enoch-chang/Flashing-Lights-Project/Photos/inside.jpg

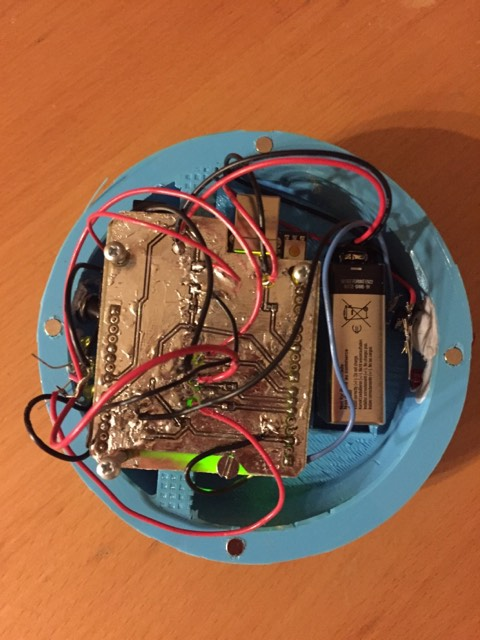
Photos/inside.jpg
