enoch-chang/Flashing-Lights-Project/Photos/three-pieces.jpg

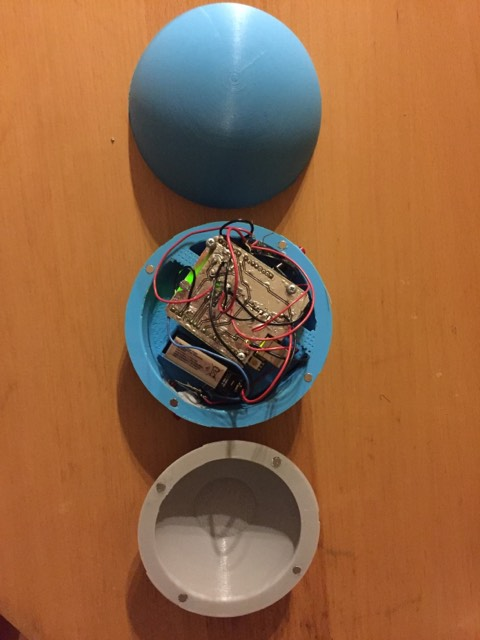
Photos/three-pieces.jpg
