enoch-chang/Flashing-Lights-Project/README.md

# Flashing-Lights-Project

Lights will be flashing.

Demo: https://youtu.be/DI44GL3oFzs
