enoch-chang/Flashing-Lights-Project/Electronics/Circuit-Sketch.pdf

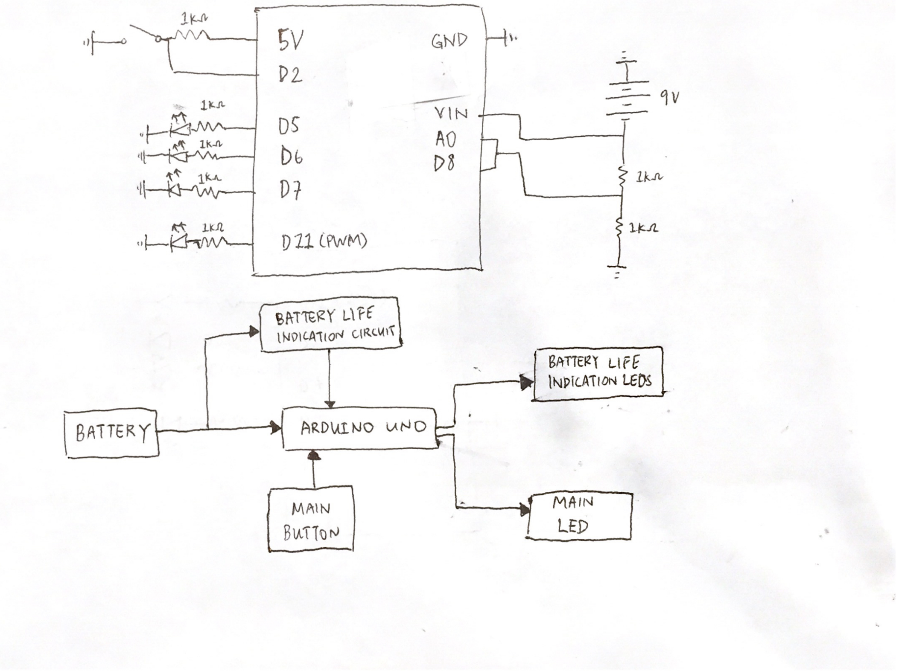
[picture p3: page 1]
