enoch-chang/Flashing-Lights-Project/Software/Software-Flowchart.pdf

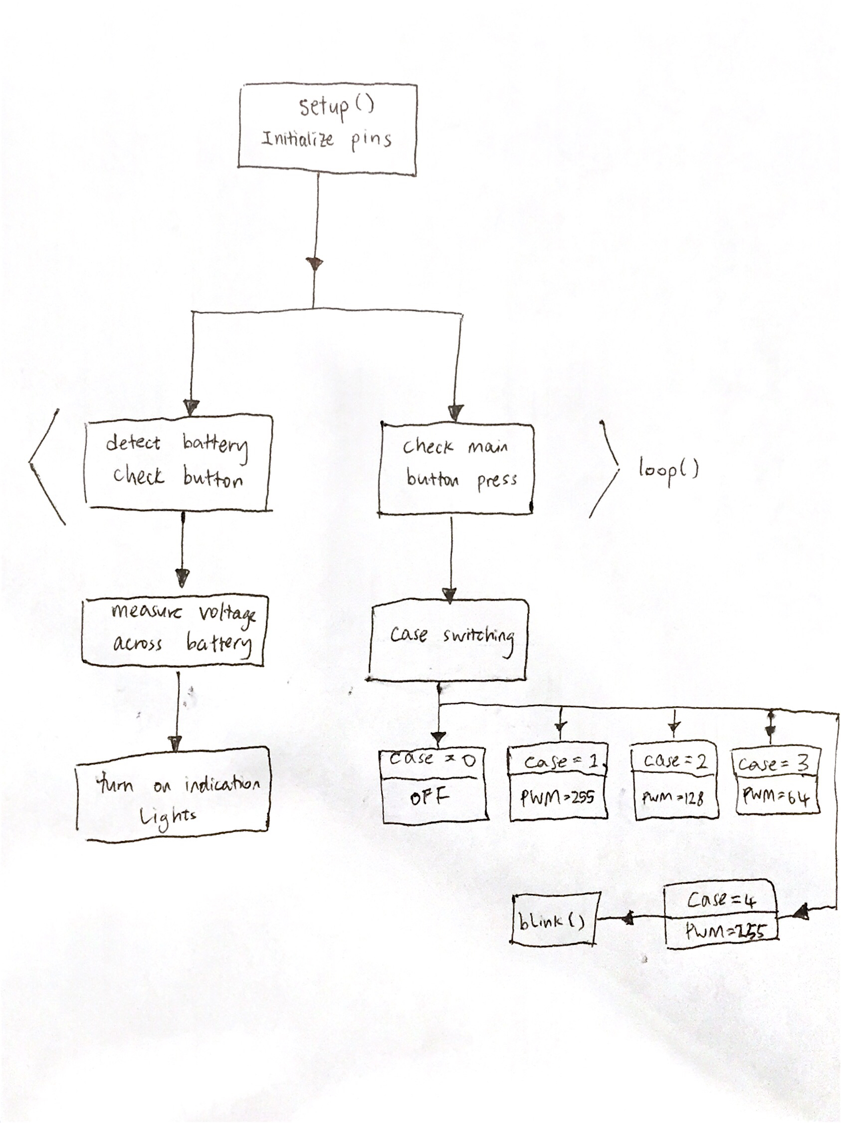
[picture p4: page 1]
