enoch-chang/Flashing-Lights-Project/Photos/back.jpg

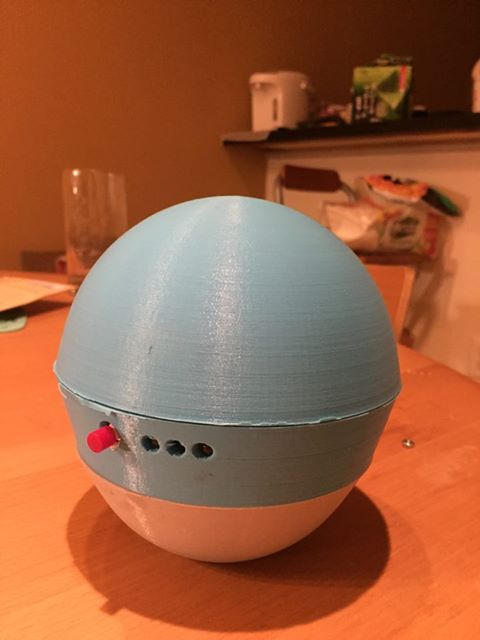
Photos/back.jpg
