enoch-chang/Flashing-Lights-Project/Photos/front.jpg

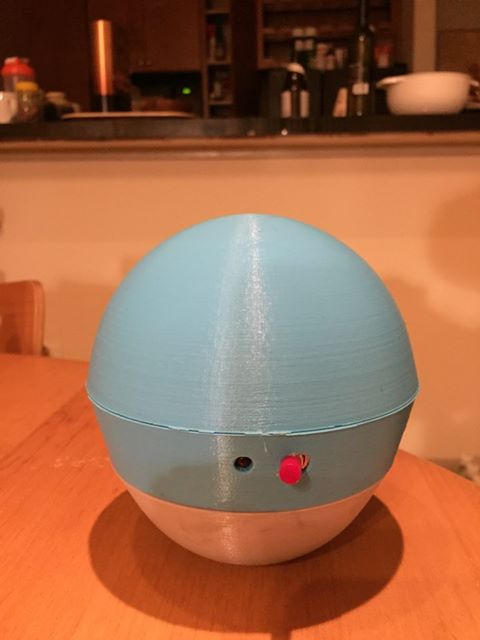
Photos/front.jpg
