enoch-chang/Flashing-Lights-Project/Mechanical/STL Files for Printing/hemisphere-middle.stl

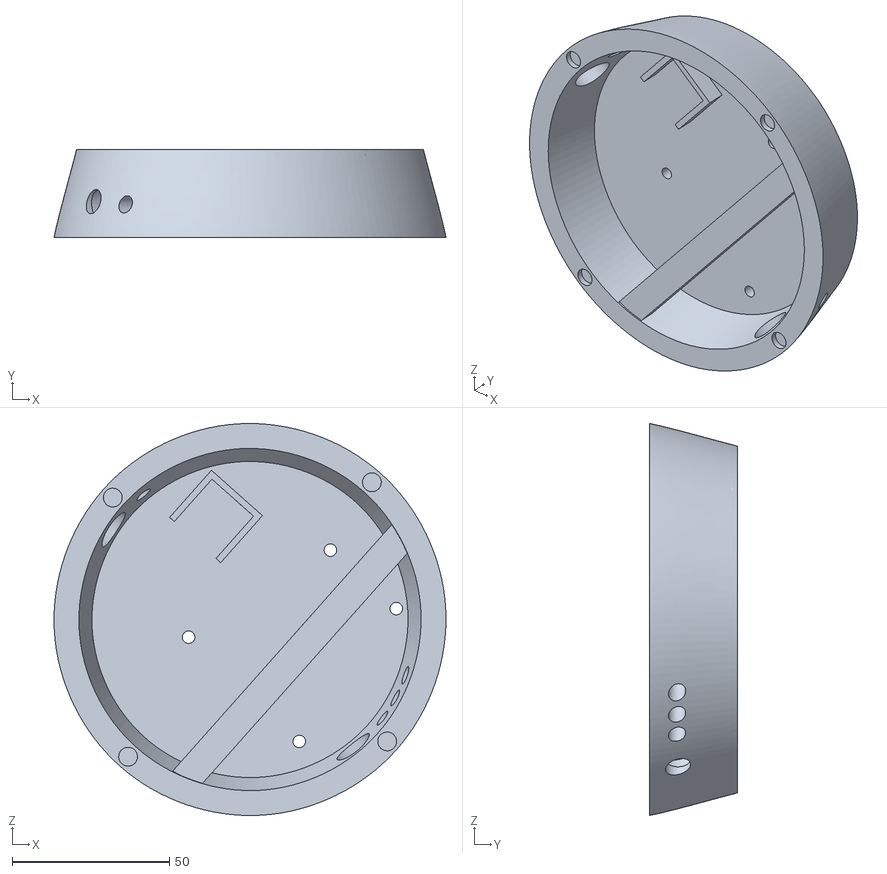
[picture p7: CAD file, 2018-12-14]
Mechanical/STL Files for Printing/hemisphere-middle.stl
124.6 x 28.0 x 124.6
