enoch-chang/Flashing-Lights-Project/Mechanical/STL Files for Printing/hemisphere-bottom.stl

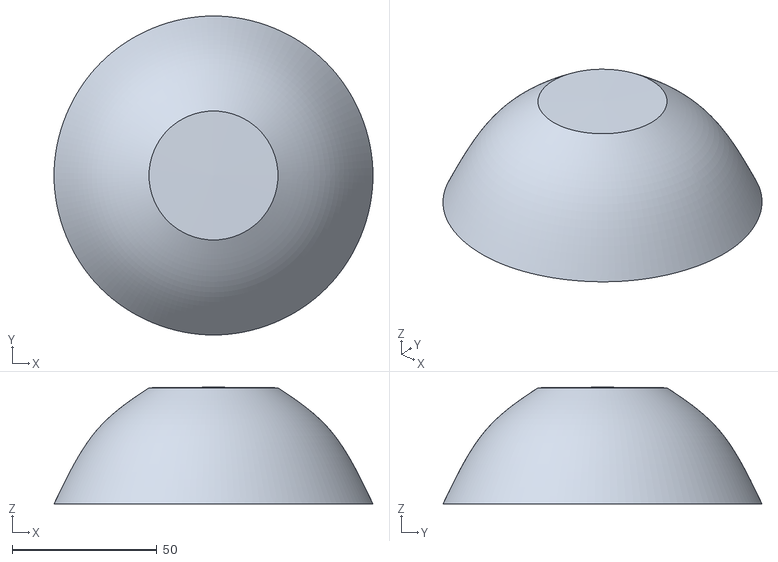
[picture p8: CAD file, 2018-12-14]
Mechanical/STL Files for Printing/hemisphere-bottom.stl
110.3 x 110.3 x 40.4
