enoch-chang/Flashing-Lights-Project/(list of files, cad)

Other CAD files:
Mechanical/Light Project 3 Piece v15.f3d
Mechanical/Light-Case-Model.f3d
