enoch-chang/Flashing-Lights-Project/Mechanical/CAD-Drawing-v1.pdf

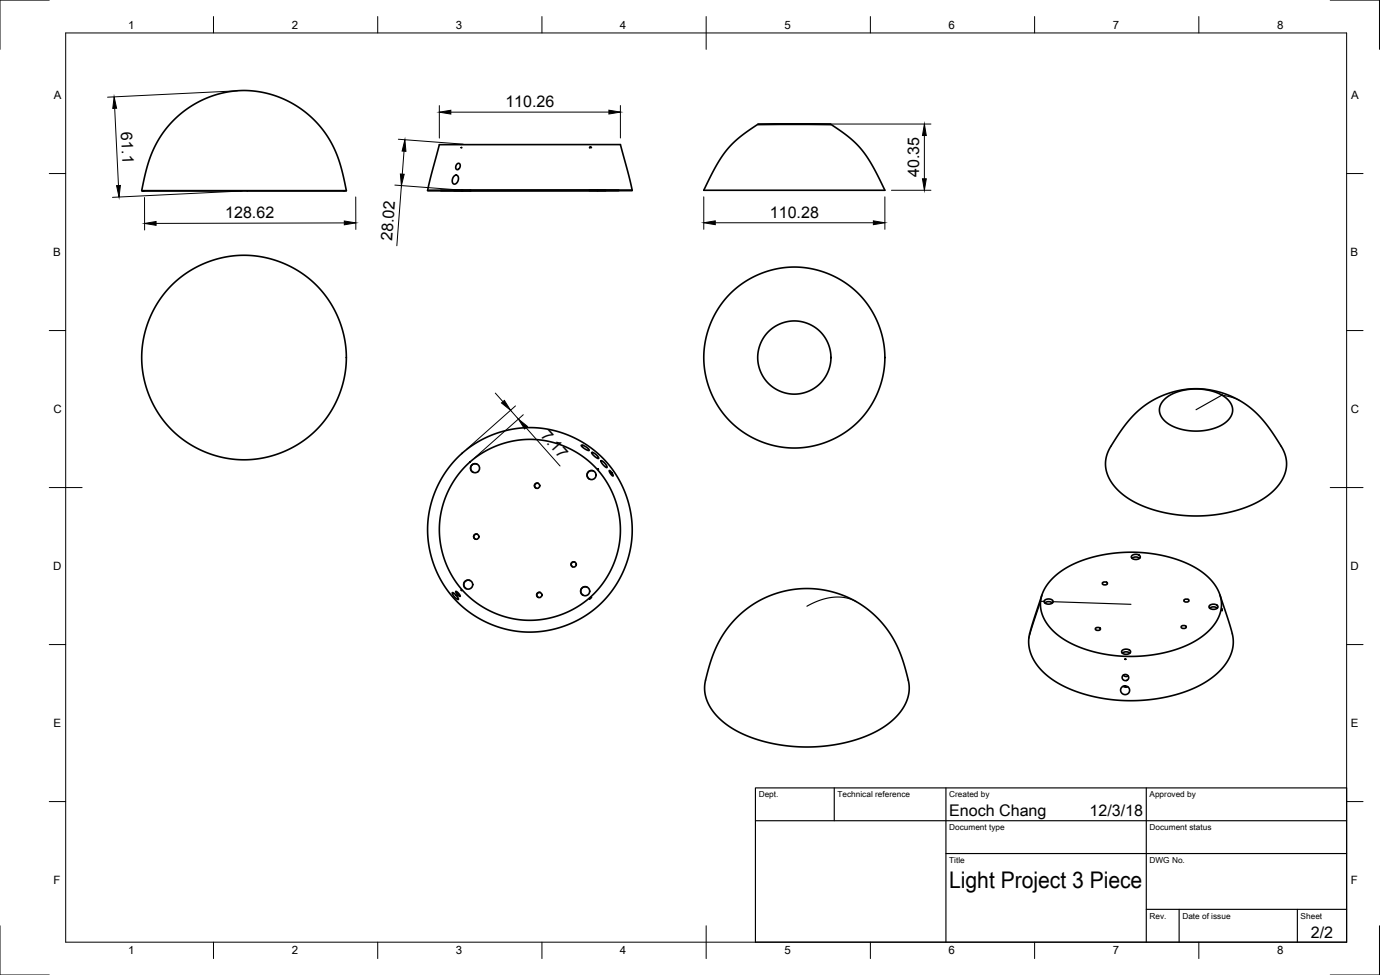
[picture p9: page 1]

Dept. | Technical reference | Created by Enoch Chang 12/3/18 | Approved by

Document type | Document status

Title Light Project 3 Piece | DWG No.

Rev. | Date of issue | Sheet 2/2
