enoch-chang/Flashing-Lights-Project/Electronics/Circuit-PCB.pdf

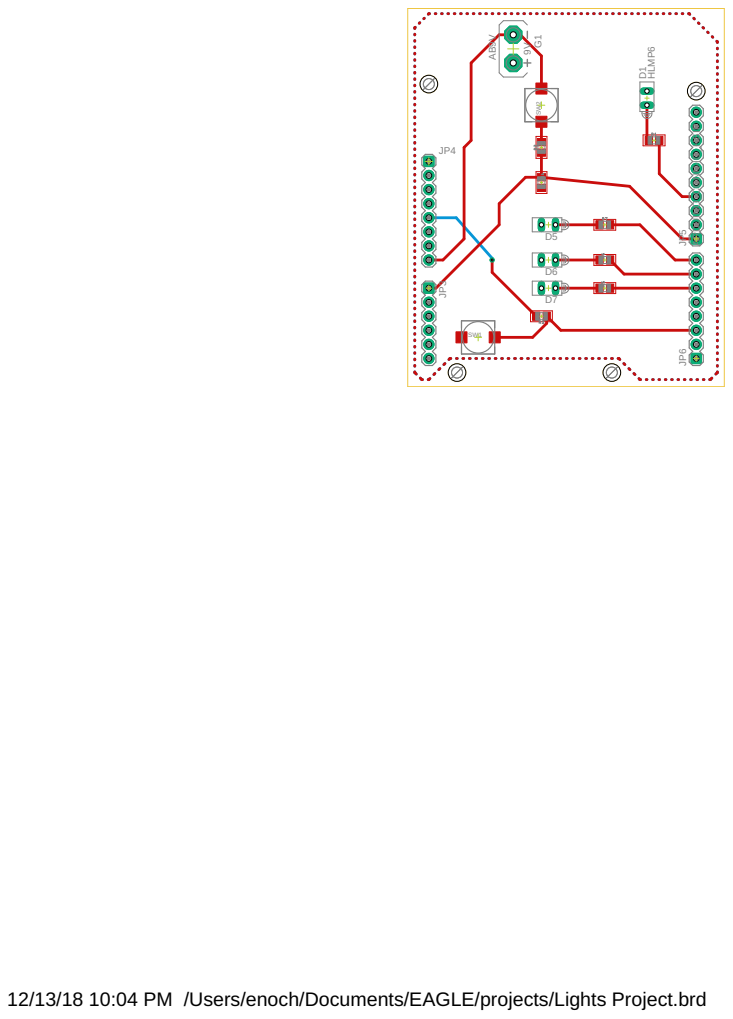
[picture p10: page 1]

12/13/18 10:04 PM /Users/enoch/Documents/EAGLE/projects/Lights Project.brd
