enoch-chang/Flashing-Lights-Project/Electronics/Circuit-Schematic.pdf

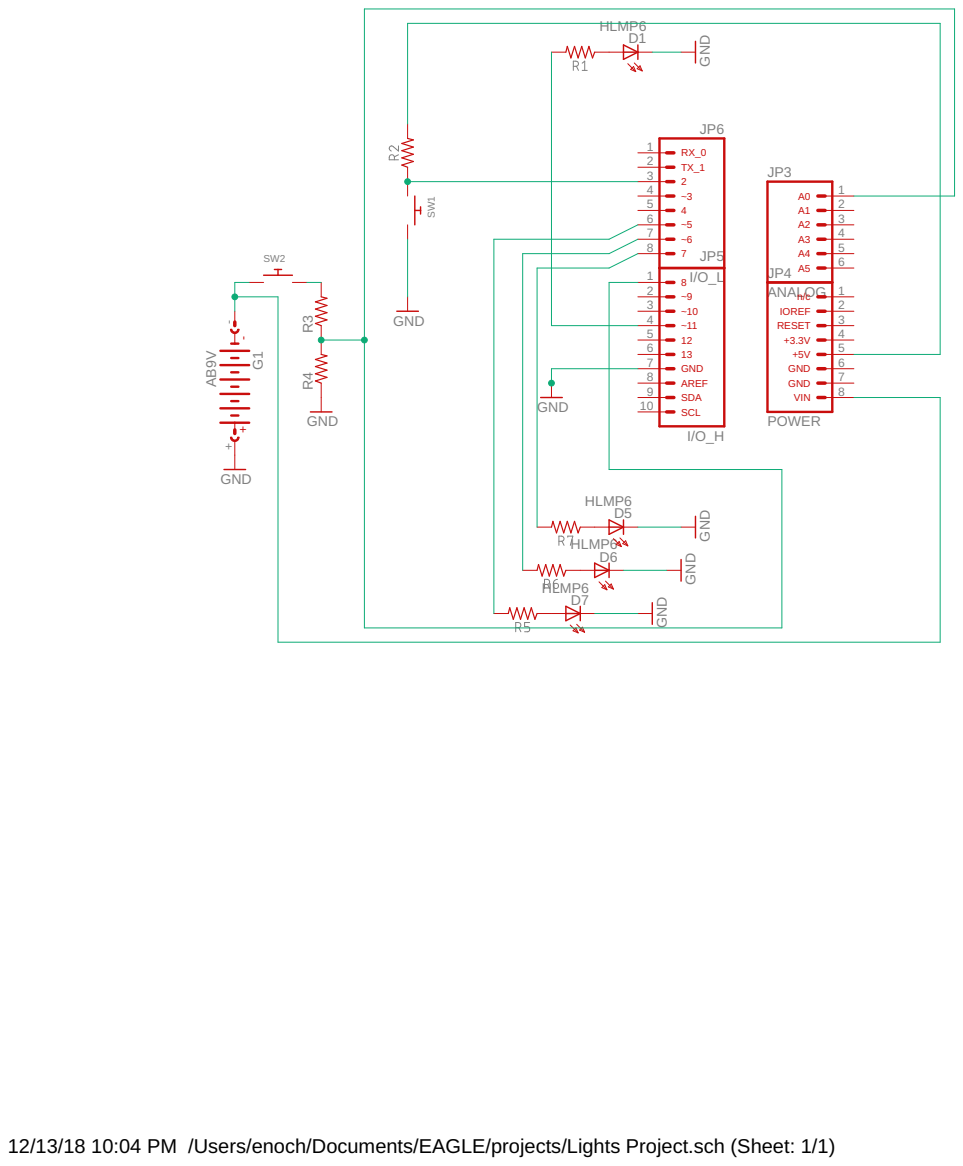
[picture p11: page 1]

12/13/18 10:04 PM /Users/enoch/Documents/EAGLE/projects/Lights Project.sch (Sheet: 1/1)
