enoch-chang/Flashing-Lights-Project/Electronics/Lights Project PCB.pdf

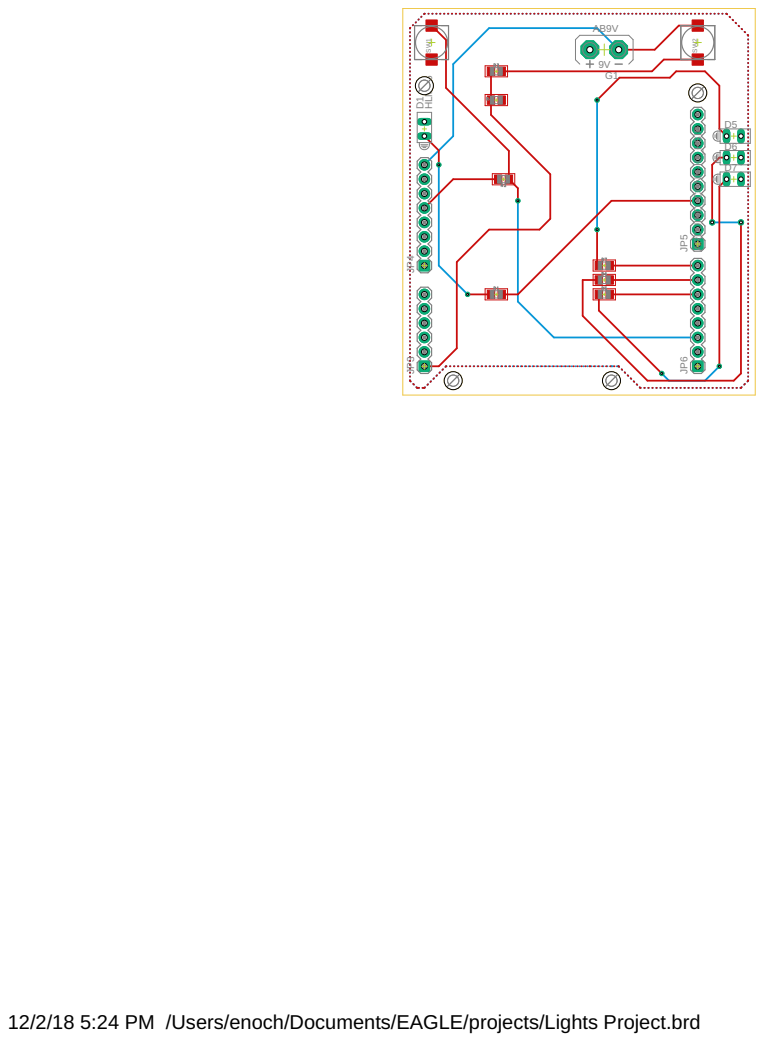
[picture p12: page 1]

12/2/18 5:24 PM /Users/enoch/Documents/EAGLE/projects/Lights Project.brd
