enoch-chang/Flashing-Lights-Project/Electronics/Lights Project.brd

## EAGLE design Electronics/Lights Project.brd (2018-11-21)

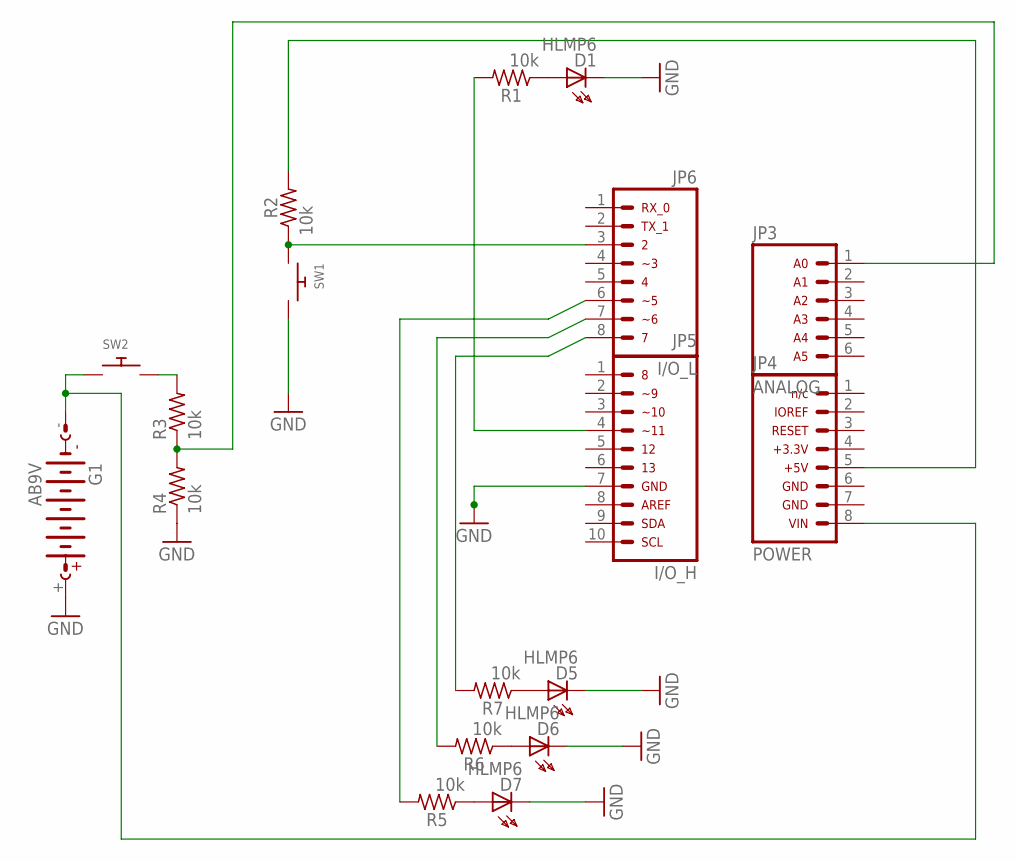
[picture p13: schematic Lights Project.sch]

Parts:
D1, D5, D6, D7: HLMP6
G1: AB9V
JP3: ARDUINO_CONN-ANALOGSIP; CONN-1X06
JP4: ARDUINO_CONN-POWERSIP; CONN-1X08
JP5: ARDUINO_CONN-IO_HSIP; CONN-1X10
JP6: ARDUINO_CONN-IO_LSIP; CONN-1X08
R1, R2, R3, R4, R5, R6, R7: 10k; R0805
SW1, SW2: SWITCH_PUSHBUTTONSOFTTOUCHSMD_SJ; PUSHBUTTON_SMD_SJ

Connections:
GND: D1.K, D5.K, D6.K, D7.K, G1.+, JP5.7, R4.1, SW1.P$2
unnamed: G1.-, JP4.8, SW2.P$1
unnamed: JP5.4, R1.2
unnamed: D1.A, R1.1
unnamed: D5.A, R7.1
unnamed: JP6.3, R2.1, SW1.P$1
unnamed: R3.2, SW2.P$2
unnamed: D6.A, R6.1
unnamed: JP6.6, R5.2
unnamed: D7.A, R5.1
unnamed: JP6.7, R6.2
unnamed: JP6.8, R7.2
unnamed: JP3.1, R3.1, R4.2
unnamed: JP4.5, R2.2

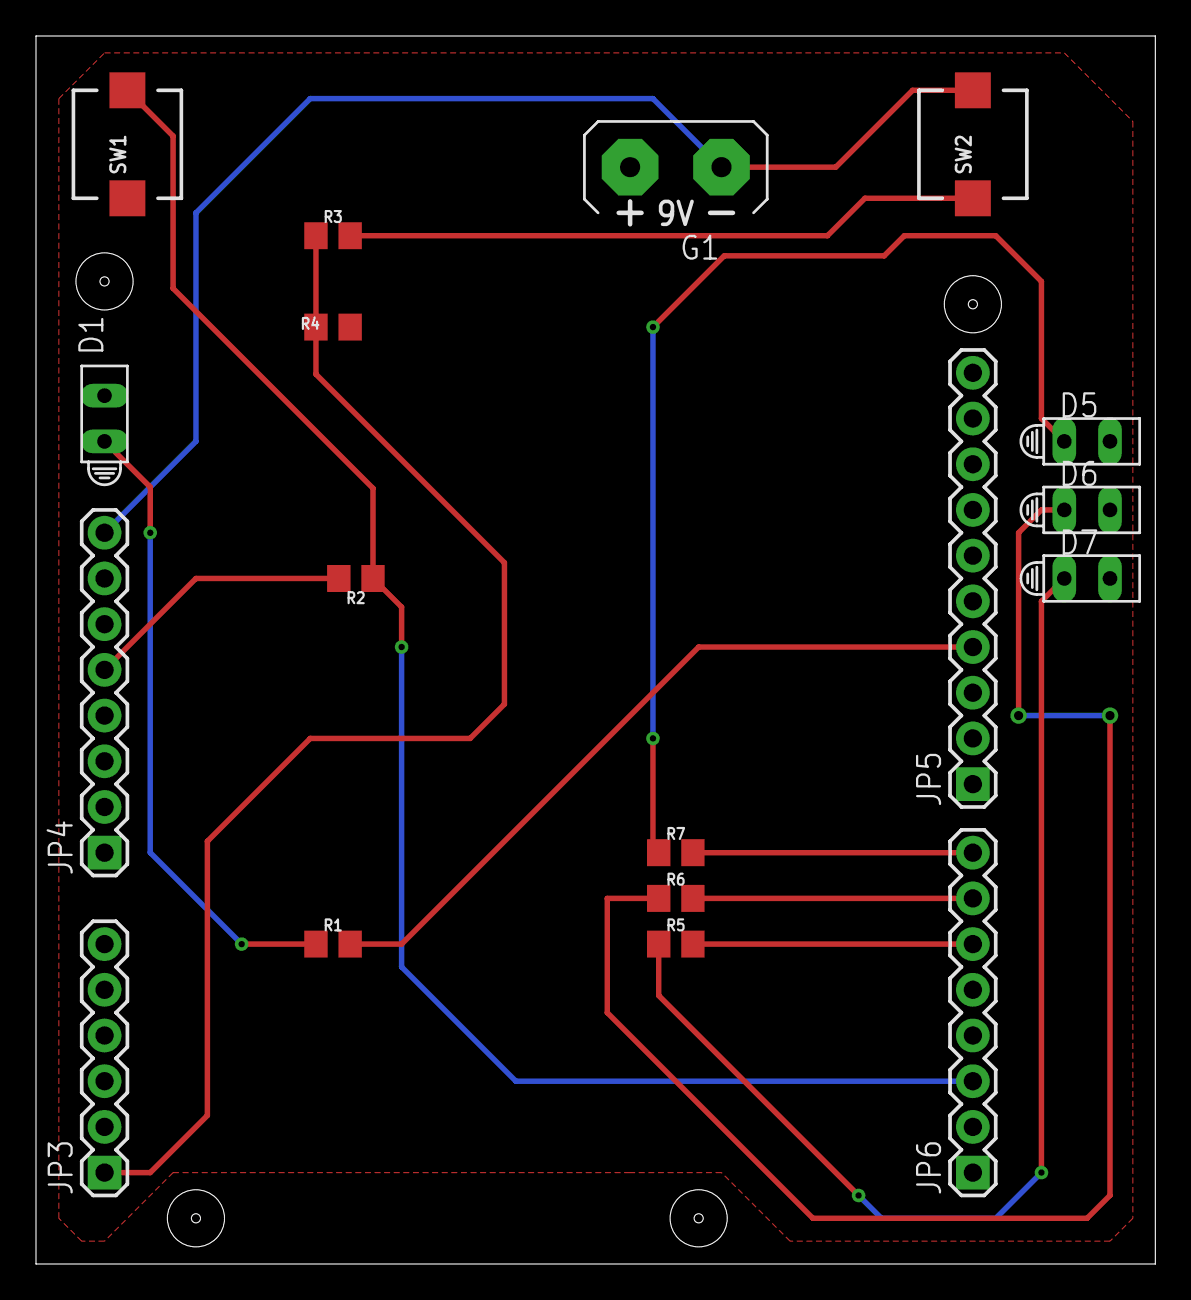
[picture p14: board Lights Project.brd from above]

Board: 2 copper layers, 62.2 x 68.2 mm, 18 parts (0 on the bottom side), 14 nets.
