enoch-chang/Flashing-Lights-Project/Electronics/PCB-board-v1.2.brd

## EAGLE design Electronics/PCB-board-v1.2.brd (2018-11-14)

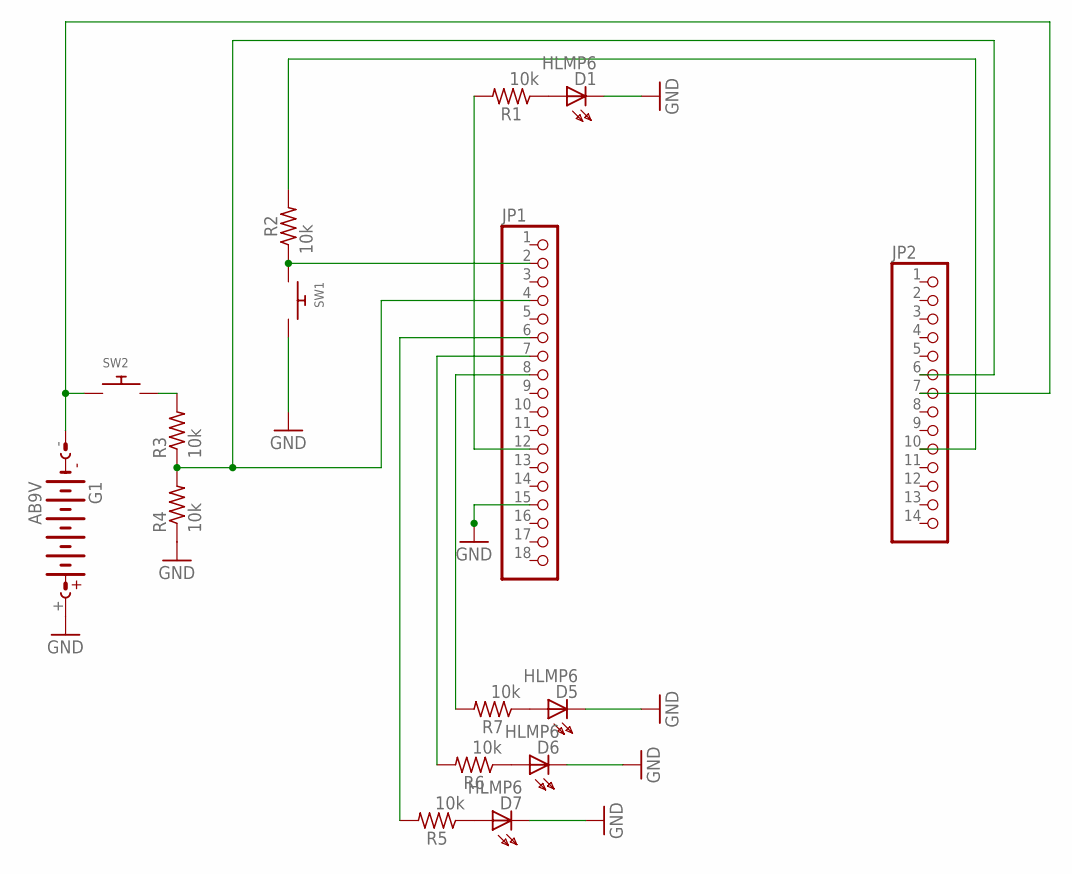
[picture p15: schematic PCB-schematic-v1.2.sch]

Parts:
D1, D5, D6, D7: HLMP6
G1: AB9V
JP1: PINHD-1X18; 1X18
JP2: PINHD-1X14; 1X14
R1, R2, R3, R4, R5, R6, R7: 10k; R0805
SW1, SW2: SWITCH_PUSHBUTTONSOFTTOUCHSMD_SJ; PUSHBUTTON_SMD_SJ

Connections:
GND: D1.K, D5.K, D6.K, D7.K, G1.+, JP1.15, R4.1, SW1.P$2
unnamed: G1.-, JP2.7, SW2.P$1
unnamed: JP1.12, R1.2
unnamed: D1.A, R1.1
unnamed: D5.A, R7.1
unnamed: JP1.2, R2.1, SW1.P$1
unnamed: R3.2, SW2.P$2
unnamed: D6.A, R6.1
unnamed: JP1.6, R5.2
unnamed: D7.A, R5.1
unnamed: JP1.7, R6.2
unnamed: JP1.8, R7.2
unnamed: JP1.4, JP2.6, R3.1, R4.2
unnamed: JP2.10, R2.2

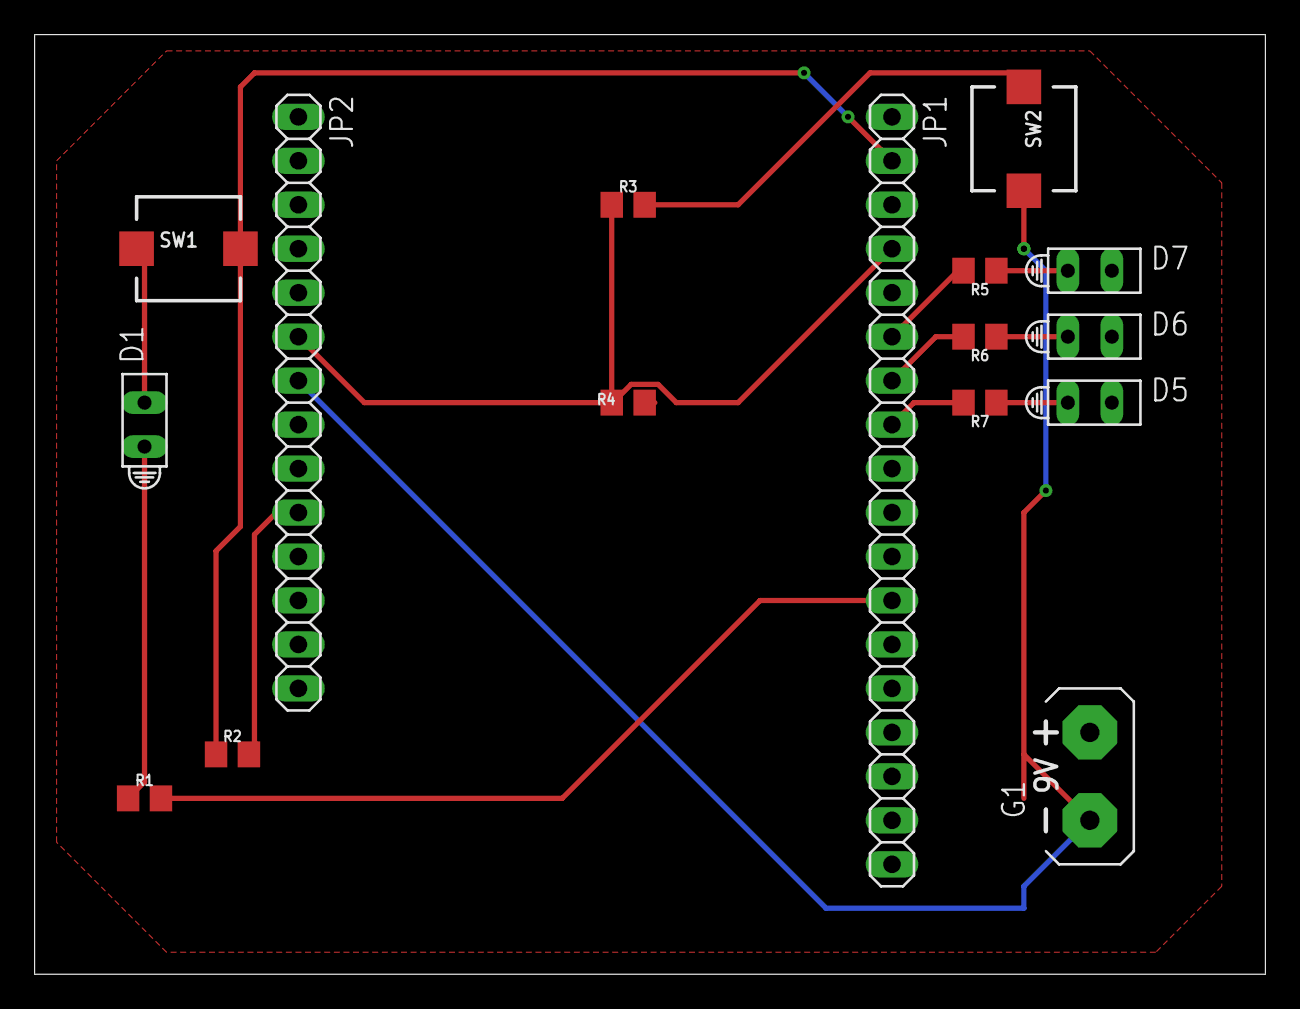
[picture p16: board PCB-board-v1.2.brd from above]

Board: 2 copper layers, 71.1 x 54.3 mm, 16 parts (0 on the bottom side), 14 nets.
