enoch-chang/Flashing-Lights-Project/(threads)

Thread 1 (2018-11-01):

Battery life indication??

enoch-chang, 2018-11-01:
Hi Dr. Palmeri

Please refer to the circuit diagram found in the 'Electronics' folder.

Been reading many different articles about how to do this... seems like a voltage division at the source seemed like the most common implementation method. I have this going into an analog input pin of the Arduino and then after some processing, representing that information as a PWM and to a separate LED. Just wanted to make sure this implementation is valid... or if you have any suggestions, I'd really appreciate that.

On a side note, I have a bypass capacitor before the regulator to prevent it from blowing out. Is this placed correctly? I noticed that Jeff from Blur had capacitors before AND after his regulator.

Thanks!

mlp6, 2018-11-02:
Looks functional, though the voltage divider approach will come at the expense of a constant current draw from the battery, which will decrease its life.

The cap after the voltage regulator is actually more important than the one before since the regulator itself will do a lot of the heavy lifting in mapping the voltage to the desired output.  The second cap helps maintain that output voltage.

mlp6, 2018-11-04:
Yep!

Closed 2018-11-09.

Thread 2 (2018-11-08):

Milestone 04

enoch-chang, 2018-11-08:
Completed first versions of PCB and software.

P.S. cannot assign Matt until he accepts my collaboration request for this repo

brinnaebent, 2018-11-12:
Schematic- something weird with VCC+ on schematic. It is routed to 3 power sources? Should only connect to 5V. Check this because this will change things on PCB.
PCB-You have routes going over/under components. We should avoid this and go around components when routeing. Your routes look very small-what size are you using?
Consider placing components between headers if making a true shield. This will reduce size of board.

enoch-chang, 2018-11-12:
Thanks for the review. A few questions!

- I have my VCC+ connected to the output of the 5V regulator - shouldn't that automatically make all instances of VCC+ equal to 5V? I have them linked in a similar way to the example the Dr. Palmeri uploaded here: https://github.com/mlp6/Fundamentals-BME-Design/blob/master/PrototypingSkills/schematic.png
... If not, how do I change to the 5V labels?

- They were size 6 - I'll go ahead and change them to size 12.

- How far should I space the headers apart by? Would I use 2 headers with 18 pins in place of the Arduino? Thanks!

sphaerobolus, 2018-11-14:
I'm sorry for any whiplash I might be causing: I don't think you need a voltage regulator if you're building a shield for the UNO. the UNO has an on-board voltage regulator. You pass through that regulator if you apply your 9V to the Vin pin.

I don't see a latest schematic, so hard for me to fully tell what's going on with latest pcb.

I'm not sure what's going on with versioning. You don't need to create new files when you have a new version. On the desktop git client, you want to commit a new version, and push to the server.

R3, R4, R5 and R7, and also C1, all appear to be mis-routed. I see a trace coming close to the pad, but not actually connecting to it.

If you're building this as a shield, why not put all of your components between the two rows of headers? You can certainly fit all of them in there, and save a lot of space.

You don't benefit, electrically, from planes top and bottom here. It does minimize the amount of copper removed, however.

Thread 5 (2018-11-14):

PCB Update

enoch-chang, 2018-11-14:
Hi @sphaerobolus

I took your comments and redid the wiring (and schematic). Please let me know if there are any problems that persist!

I do have two concerns:
- How do I know if the headers are spaced correctly (i.e. if the UNO can fit onto it)
- The pins on the UNO are not spaced evenly (there is a gap on each side) - how do I account for that on the headers to ensure that the UNO fits onto it?

Thanks!

Enoch

sphaerobolus, 2018-11-14:
To see if the headers are spaced correctly, and to make sure the UNO plugs in, you'll of course want to see the dimensions for the UNO. You could use calipers to measure them. But of course other people have solved this problem before you and have published the dimensions. They're not hard to find. You could grab them and lay out all four groups of pins according to the published dimensions. Better yet, a template for an UNO shield is published. You could download that part library and add it to your design.

Thread 7 (2018-11-20):

Milestone 05 Review

ps178, 2018-11-20:
Please dont forget to create issues for the milestone reviews.

You CAD looks good. Some notes:
- How will the two parts (the top and bottom sphere halves) stay together? The user needs to have access to the battery to change it.
- I hope you considered the length of the LED and the button to bend over from the PCB to the holes.
- You have two circles and a line floating on your CAD file.

enoch-chang, 2018-11-21:
Thanks for the comments.

I just updated my model -- I would appreciate if you could have a look at it.

In summary, I've split the sphere into three parts.
- Four screws and bolts will be used to fix the Arduino, PCB and the middle section of the sphere.
- I have yet to figure out how to attach the LEDs and buttons to the case (but they will be attached to wires that extend from the PCB).
-The separate sections of the sphere case will attach together via some small magnetic disks (5 mm diameter x 2 mm depth) that will be placed into the rims of each connecting part (you will see 4 holes on each side). I have ordered these magnets from Amazon and should arrive soon!
- The battery will rest between the board and the bottom of the middle section of the sphere

Thanks again!

ps178, 2018-11-23:
I think your CAD is looking good! The three part approach is definitely a lot better. I think you are ready to print your design so that you have an idea of how well it prints and what it looks physically.

Thread 11 (2018-11-21):

PCB Update Review

enoch-chang, 2018-11-21:
I've taken previous feedback as well as added headers and holes. Please let me know if this looks ready to go!

Thanks.

sphaerobolus, 2018-11-22:
I did not verify your header placement. As long as you're confident these line up with the pattern on the Uno, you're good to go. We can etch this.
