enoch-chang/Flashing-Lights-Project/(commit log)

2018-11-01 Add software and circuit sketches
2018-11-01 Modified Circuit Diagram - added LED for battery life indication
2018-11-06 Add Arduino code - main functionality working
2018-11-08 Added battery indication functionality
2018-11-08 Added *.sch and *brd files for PCB design
    [PCB-board-v1.brd, PCB-schematic-v1.sch]
2018-11-12 Rewired and rearranged some components to save space
    [PCB-board-v1.1.brd]
2018-11-14 Added v1.2 of PCB afte Brinnae's comments
    [PCB-board-v1.2.brd, PCB-schematic-v1.2.sch]
2018-11-19 Added CAD models and drawings
    [Light Project v4.f3d]
2018-11-21 Completed light case CAD model
    [Light Project v4.f3d, light-case.f3d]
2018-11-21 Updated PCB and Schematic: added headers and holes
    [Lights Project.brd, Lights Project.sch]
2018-11-30 Finalized CAD and ECAD designs added
    [Light Project 3 Piece v15.f3d, Light Project v4.f3d]
2018-12-02 Added PDFs of finalized PCB design
    [PCB-board-v1.1.brd, PCB-schematic-v1.sch]
2018-12-03 Updated CAD drawing
2018-12-14 Updated all electronics files
    [Circuit-PCB.brd, Circuit-Schematic.sch, PCB-board-v1.1.brd, PCB-schematic-v1.2.sch]
2018-12-14 Updated CAD model; added *.stl files used for 3D printing
    [Light-Case-Model.f3d, hemisphere-bottom.stl, hemisphere-middle.stl, light-case.f3d]
2018-12-14 Updated code with fixed formatting
    [light-code-v1.ino]
2018-12-14 Updated software flowchart
